DoctorDehi/Lucy_maturitni_projekt/img/vozitko_20210512_180402.jpg

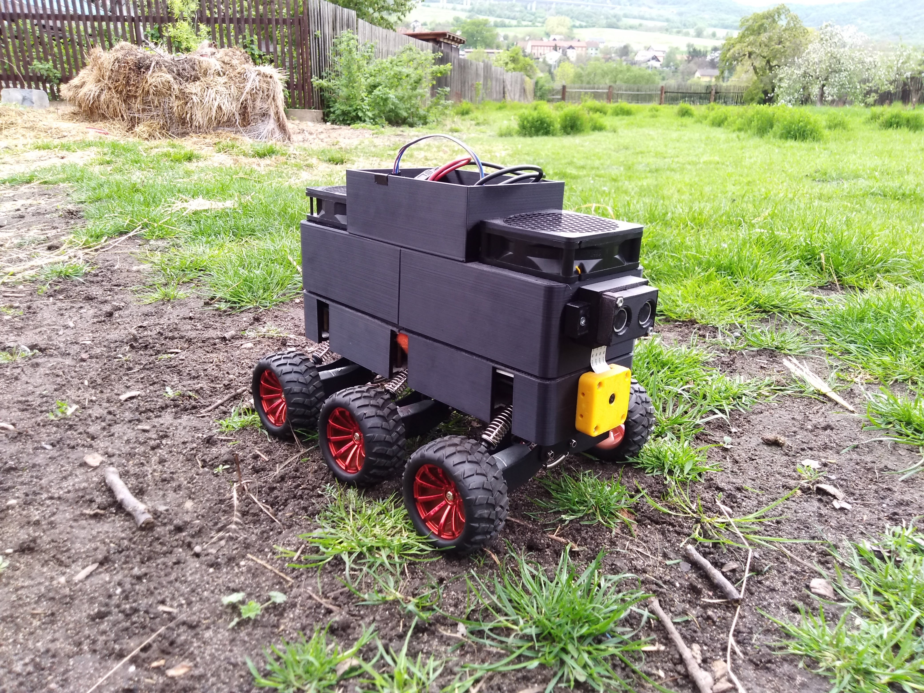
img/vozitko_20210512_180402.jpg
