DoctorDehi/Lucy_maturitni_projekt/README.md

# Lucy

Repozitář maturitního projektu IVE. 
Vozítko ovládané přes internet, které sbírá data z modulů.

Tento repozitář je na RPi vozítka umístěn v adresáři /home/pi/dev/Lucy

### Jednoduchý návod
* Pro jízdu zapněte vozítko vypínačem pod horním krytem vozítka. Počkejte zhruba 1 minutu a poté přejděte na adresu https://lucy.odbornaskola.cz/. Zde se přihlaště do webového rozhraní.

    Uživatel: host</br>
    Heslo: host1234

* Po ukončení jízdy **vypněte nejprve operační systém vozítka!!!** To lze učinit kliknutím na tlačítko "vypnout systém" umístěném v menu webového rozhraní.

* Pokud vozítko začne "pípat", co nejdříve vozítko vypněte a připojte na nabíječku.

Lucy
