DoctorDehi/Lucy_maturitni_projekt/img/htop-running-all_04-05-2021.png

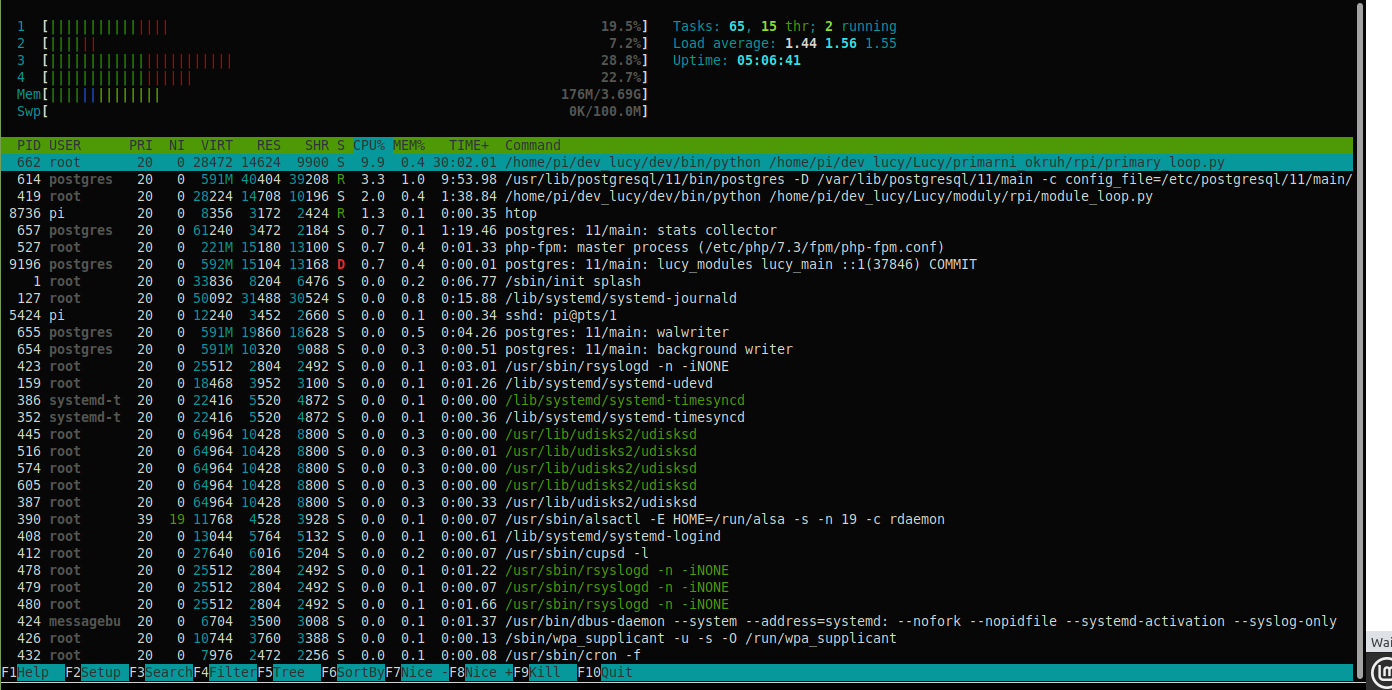
img/htop-running-all_04-05-2021.png
