DoctorDehi/Lucy_maturitni_projekt/img/Lucy-jednoduche_schema_komunikace_mezi_jednotkami.png

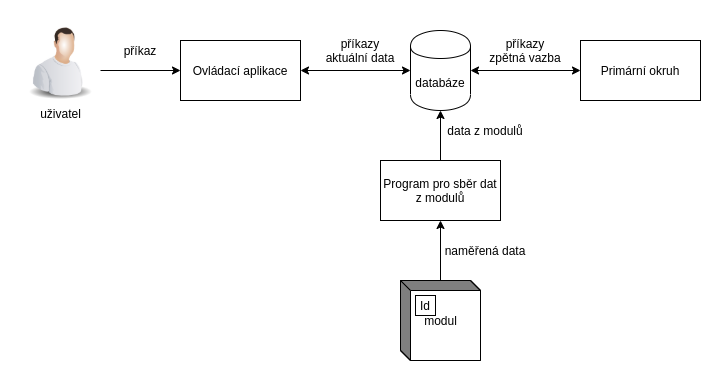
img/Lucy-jednoduche_schema_komunikace_mezi_jednotkami.png
